LukeSky91/FlexRC/wykres_skalowania_joy.xlsx

Sheet: Joy_sim
SYMULATOR SKALOWANIA OSI JOYSTICKA (ESP32-S3, ADC 12-bit)
 | 1. PARAMETRY WEJŚCIOWE
 | Parametr | Wartość | Jednostka | Opis
 | Vfs | 3.10 | V | Pełna skala napięcia ADC
 | ADC_MAX | 4095 | - | Maksymalna wartość ADC (12-bit)
 | calMin | 300 | ADC | Dolna granica kalibracji
 | center | 2048 | ADC | Środek wychylenia
 | calMax | 3800 | ADC | Górna granica kalibracji
 | invert | NIE | - | Inwersja kierunku ADC
 | deadzone | 100 | ADC | Martwa strefa wokół środka
 | expo (obecna krzywa) | 3.00 | - | Wykładnik krzywej OBECNEJ, zakres 0-3
 | k (nowe RC expo) | 0.80 | - | Współczynnik krzywej NOWEJ (RC expo), zakres 0-1
 | p (potęga NOWA) | 3.50 | - | Wykładnik członu nieliniowego krzywej NOWEJ (RC expo), zalecane 3-9 (3 = oryginalny sześcian)
 | limit % | 100 | % | Limit wychylenia, zakres 0-100
 | 2. ALGORYTM – WARTOŚCI PO ZABEZPIECZENIACH FIRMWARE |  |  |  | Pomocnicze do wykresu (V)
 | calMin_eff | 300 | ADC | Jeśli calMax<=calMin+2 → calMin=0 | V(center) | 1.55037851
 | calMax_eff | 3800 | ADC | Jeśli calMax<=calMin+2 → calMax=ADC_MAX | V(center-deadzone) | 1.474676435
 | center_eff | 2048 | ADC | Jeśli center poza [calMin_eff;calMax_eff] → środek przedziału | V(center+deadzone) | 1.626080586
 | spanPos | 1752 | ADC | Zakres dodatni
 | spanNeg | 1748 | ADC | Zakres ujemny
 | ADC dla raw=calMin_eff (uwzgl. invert) | 300 | ADC
 | ADC dla raw=calMax_eff (uwzgl. invert) | 3800 | ADC
 | V dla calMin_eff (granica wykresu) | 0.2271062271 | V
 | V dla calMax_eff (granica wykresu) | 2.876678877 | V
 | 3. PRZELICZENIE "NA TERAZ"
 | V_now | 2.70 | V
 | Krok | OBECNA (powf) | NOWA (RC expo)
 | ADC | 3567 | 3567
 | raw | 3567 | 3567
 | center (eff.) | 2048 | 2048
 | c = raw - center | 1519 | 1519
 | sign | 1 | 1
 | absC | 1519 | 1519
 | xMax | 1752 | 1752
 | czy w deadzone? | NIE | NIE
 | norm | 0.8589588378 | 0.8589588378
 | % wychylenia (liniowo) | 85.89588378 | 85.89588378
 | curved (przed limitem) | 54.43640166 | 64.16785412
 | curved po limicie | 54.43640166 | 64.16785412
 | out | 54.43640166 | 64.16785412
 | tx (int8) | 54 | 64
 | WYNIK (tx wysyłany radiem)
 | tx OBECNA | 54
 | tx NOWA | 64
 | 4. TABELA POMOCNICZA DO WYKRESU (201 pkt) |  |  |  |  |  |  |  |  |  |  |  |  |  |  |  | Dane pomocnicze do wykresu (nie edytować)
 | V [V] | ADC | raw | c | absC | xMax | deadzone? | norm | % wychylenia (liniowo) | curved OBECNA (po limicie) | curved NOWA (po limicie) | out OBECNA | out NOWA | tx OBECNA | tx NOWA |  | V [V] | Liniowo | Obecna (powf) | Nowa (RC expo) | V_now | tx_now | V(center) | y | V(dz-) | y | V(dz+) | y
 | 0.240 | 318 | 318 | -1730 | 1730 | 1748 | NIE | 0.989 | -98.9 | 95.70 | 96.76 | -95.70 | -96.76 | -96 | -97 |  | 0.2403540904 | -98.90776699 | -96 | -97 | 2.7 | 54 | 1.55037851 | -100 | 1.474676435 | -100 | 1.626080586 | -100
 | 0.254 | 335 | 335 | -1713 | 1713 | 1748 | NIE | 0.979 | -97.9 | 91.77 | 93.78 | -91.77 | -93.78 | -92 | -94 |  | 0.2536019536 | -97.87621359 | -92 | -94 | 2.7 | 64 | 1.55037851 | 100 | 1.474676435 | 100 | 1.626080586 | 100
 | 0.267 | 353 | 353 | -1695 | 1695 | 1748 | NIE | 0.968 | -96.8 | 87.74 | 90.71 | -87.74 | -90.71 | -88 | -91 |  | 0.2668498168 | -96.78398058 | -88 | -91
 | 0.280 | 370 | 370 | -1678 | 1678 | 1748 | NIE | 0.958 | -95.8 | 84.06 | 87.88 | -84.06 | -87.88 | -84 | -88 |  | 0.2800976801 | -95.75242718 | -84 | -88
 | 0.293 | 388 | 388 | -1660 | 1660 | 1748 | NIE | 0.947 | -94.7 | 80.29 | 84.95 | -80.29 | -84.95 | -80 | -85 |  | 0.2933455433 | -94.66019417 | -80 | -85
 | 0.307 | 405 | 405 | -1643 | 1643 | 1748 | NIE | 0.936 | -93.6 | 76.85 | 82.26 | -76.85 | -82.26 | -77 | -82 |  | 0.3065934066 | -93.62864078 | -77 | -82
 | 0.320 | 423 | 423 | -1625 | 1625 | 1748 | NIE | 0.925 | -92.5 | 73.32 | 79.49 | -73.32 | -79.49 | -73 | -79 |  | 0.3198412698 | -92.53640777 | -73 | -79
 | 0.333 | 440 | 440 | -1608 | 1608 | 1748 | NIE | 0.915 | -91.5 | 70.11 | 76.93 | -70.11 | -76.93 | -70 | -77 |  | 0.3330891331 | -91.50485437 | -70 | -77
 | 0.346 | 458 | 458 | -1590 | 1590 | 1748 | NIE | 0.904 | -90.4 | 66.82 | 74.30 | -66.82 | -74.30 | -67 | -74 |  | 0.3463369963 | -90.41262136 | -67 | -74
 | 0.360 | 475 | 475 | -1573 | 1573 | 1748 | NIE | 0.894 | -89.4 | 63.82 | 71.88 | -63.82 | -71.88 | -64 | -72 |  | 0.3595848596 | -89.38106796 | -64 | -72
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
 | 2.863 | 3783 | 3783 | 1735 | 1735 | 1752 | NIE | 0.990 | 99.0 | 95.95 | 96.95 | 95.95 | 96.95 | 96 | 97 |  | 2.863431013 | 98.97094431 | 96 | 97
 | 2.877 | 3800 | 3800 | 1752 | 1752 | 1752 | NIE | 1.000 | 100.0 | 100.00 | 100.00 | 100.00 | 100.00 | 100 | 100 |  | 2.876678877 | 100 | 100 | 100
 | 2.890 | 3818 | 3818 | 1770 | 1770 | 1752 | NIE | 1.000 | 100.0 | 100.00 | 100.00 | 100.00 | 100.00 | 100 | 100 |  | 2.88992674 | 100 | 100 | 100
 | 6. TESTY (sprawdzenie dla parametrów domyślnych)
 | Opis testu | V_test [V] | ADC | raw | c | sign | absC | xMax | norm | curved OBECNA | curved NOWA | out OBECNA | out NOWA | tx OBECNA | tx NOWA | oczek. OBECNA | oczek. NOWA | OK? OBECNA | OK? NOWA
 | ADC = center_eff → tx=0 | 1.55037851 | 2048 | 2048 | 0 | 1 | 0 | 1752 | 0 | 0 | 0 | 0 | 0 | 0 | 0 | 0 | 0 | OK | OK
 | ADC = calMax_eff → tx=100 | 2.876678877 | 3800 | 3800 | 1752 | 1 | 1752 | 1752 | 1 | 100 | 100 | 100 | 100 | 100 | 100 | 100 | 100 | OK | OK
 | ADC = calMin_eff → tx=-100 | 0.2271062271 | 300 | 300 | -1748 | -1 | 1748 | 1748 | 1 | 100 | 100 | -100 | -100 | -100 | -100 | -100 | -100 | OK | OK
 | norm = 0.5 → OBECNA≈14, NOWA≈31 | 2.251379731 | 2974 | 2974 | 926 | 1 | 926 | 1752 | 0.5 | 6.25 | 17.07106781 | 6.25 | 17.07106781 | 6 | 17 | 14 | 31 | BŁĄD | BŁĄD

Sheet: MCU
component | analog sig | digital sig | comm |  | ARDUINO NANO
JOY L | 2 | 1 |  | SCK | D13 | D12 | MISO |  |  |  |  |  |  |  |  | ESP32-S3-Pico - Waveshare Wiki (https://www.waveshare.com/wiki/ESP32-S3-Pico)
JOY R | 2 | 1 |  |  | 3V3 | D11 | MOSI |  |  |  | ESP32-S3 WAVESHARE
5x KEY | 1 |  |  |  | AREF | D10 | CSN |  |  |  | 40 | VBUS | GP11 | 1 | SW_U1
2-3 FUN. KEYS |  | 2-3 |  | LX | A0 | D9 | CE |  |  | 5V IN | 39 | VSYS | GP12 | 2 | SW_L1
3-5x LED RGB |  | 1 |  | LY | A1 | D8 | LED RGB |  |  | GND | 38 | GND | GND | 3
OLED |  |  | I2C | RX | A2 | D7 | JOY R SW |  |  |  | 37 | 3V3_EN | GP13 | 4 | SW_C1
IMU |  |  | I2C | RY | A3 | D6 | JOY L SW |  |  |  | 36 | 3V3_OUT | GP14 | 5 | SW_R1
NRF24 PA LNA |  |  | SPI | SDA | A4 | D5 | BUZZ |  |  |  | 35 | ADC1_CH9 | GP15 | 6 | SW_D1
BATT LVL | 1 |  |  | SCL | A5 | D4 | SW2 |  |  |  | 34 | ADC1_CH8 | GP16 | 7
 |  |  |  | BATT | A6 | D3 | SW3-1 |  |  |  | 33 | GND | GND | 8
 |  |  |  | 5xKEY | A7 | D2 | SW3-2 |  |  | JOY R SW | 32 | ADC1_CH7 | GP17 | 9 | SDA
 |  |  |  |  | 5V | GND |  |  |  | JOY L SW | 31 | ADC1_CH6 | GP18 | 10 | SCL
 |  |  |  |  | RESET | RESET |  |  |  |  | 30 | RUN | GP33 | 11
 |  |  |  |  | GND | D0 |  |  |  | BATT | 29 | ADC1_CH5 | GP34 | 12 | SCK
 |  |  |  |  | VIN | D1 |  |  |  |  | 28 | GND | GND | 13
 |  |  |  |  |  |  |  | POT HALL |  | LX | 27 | ADC1_CH4 | GP35 | 14 | MISO
 |  |  |  |  |  |  |  | min | 0.47 | LY | 26 | ADC1_CH3 | GP36 | 15 | MOSI
 |  |  |  |  |  |  |  | mid | 1.305 | RX | 25 | ADC1_CH1 | GP37 | 16 | CSN
 |  |  |  |  |  |  |  | max | 2.2 | RY | 24 | ADC1_CH0 | GP38 | 17 | CE
 |  |  |  |  |  |  |  |  |  |  | 23 | GND | GND | 18
 |  |  |  |  |  |  |  | IMU i2c |  | SW_F1 | 22 | GP41 | GP39 | 19 | LED RGB
 |  |  |  |  |  |  |  |  |  | SW_F2 | 21 | GP42 | GP40 | 20
 |  |  |  |  |  |  |  |  |  |  |  | Waveshare |  | Sterownik WaveShare ESP32-S3-Pico • Cena, Opinie - Allegro (https://allegro.pl/produkt/sterownik-waveshare-esp32-s3-pico-0415ba11-c58a-4e15-a465-8a660298ffb0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)
 |  |  |  |  |  |  |  |  |  |  |  | 2x18650
 |  |  |  |  |  |  |  |  |  |  |  | BUCK 3.3V |  | AP63203 - przetwornica step-down BabyBuck - 3,3V 2A - SparkFun COM-18357 (https://botland.com.pl/przetwornice-step-down/20235-ap63203-przetwornica-step-down-babybuck-33v-2a-sparkfun-com-18357-5904422352097.html)
 |  |  |  |  |  |  |  |  |  |  |  | ~~buzzer~~
 |  |  |  |  |  |  |  |  |  |  |  | SW2 | ??
 |  |  |  |  |  |  |  |  |  |  |  | SW3 | ??
 |  |  |  |  |  |  |  |  |  |  |  | przełącznik ON-OFF |  | Przełącznik suwakowy ESP2010 - kątowy (https://botland.com.pl/przelaczniki-spdt/256-przelacznik-suwakowy-esp2010-katowy-5904422372781.html)
 |  |  |  |  |  |  |  |  |  |  |  |  |  | Potencjometr montażowy leżący 10kΩ - 5szt. (https://botland.com.pl/potencjometry-obrotowe-suwakowe-i-liniowe/307-potencjometr-montazowy-lezacy-10k-5szt-5904422372804.html)
 |  |  |  |  |  |  |  |  |  |  |  |  |  | Przełącznik monostabilny PB07C 7x7mm - 5 szt. (https://botland.com.pl/przelaczniki-przyciskowe-i-elektryczne/14950-przelacznik-monostabilny-pb07c-7x7mm-5-szt-5904422304058.html)
 |  |  |  |  |  |  |  |  |  |  |  |  |  | Mikroprzełącznik bistabilny ON-ON 7x7mm 5szt. (https://botland.com.pl/przelaczniki-przyciskowe-i-elektryczne/1416-mikroprzelacznik-bistabilny-on-on-7x7mm-5szt-5904422300005.html)
 |  |  |  |  |  |  |  |  |  |  |  | bezpieczniki polimerowe
 |  |  |  |  |  |  |  |  |  |  |  | BMS |  | 2S Li-ion 18650 Lithium Battery Charger Protection Board 7.4V Overcurrent Overcharge Overdischarge Protection 4A 2 Series BMS - AliExpress 502 (https://pl.aliexpress.com/item/33017997012.html?sourceType=1)
 |  |  |  |  |  |  |  |  |  |  |  | CHARGER |  | Wielokomorowy konwerter doładowania USB 2S 3S typu C moduł zasilania płyta ochronna ładowarki LiPo-polimerowej litowo-jonowej - AliExpress 502 (https://pl.aliexpress.com/item/1005005976542467.html?sourceType=1)
 |  |  |  |  |  |  |  |  |  |  | TOP VIEW
 |  |  |  |  |  |  |  |  |  |  | ESP32-S3 WAVESHARE
 |  |  |  |  |  |  |  |  |  |  | 21 | GP42 | GP40 | 20
 |  |  |  |  |  |  |  |  |  |  | 22 | GP41 | GP39 | 19
 |  |  |  |  |  |  |  |  |  |  | 23 | GND | GND | 18
 |  |  |  |  |  |  |  |  |  |  | 24 | ADC1_CH0 | GP38 | 17
 |  |  |  |  |  |  |  |  |  |  | 25 | ADC1_CH1 | GP37 | 16
 |  |  |  |  |  |  |  |  |  |  | 26 | ADC1_CH3 | GP36 | 15
 |  |  |  |  |  |  |  |  |  |  | 27 | ADC1_CH4 | GP35 | 14
 |  |  |  |  |  |  |  |  |  |  | 28 | GND | GND | 13
 |  |  |  |  |  |  |  |  |  |  | 29 | ADC1_CH5 | GP34 | 12
 |  |  |  |  |  |  |  |  |  |  | 30 | RUN | GP33 | 11
 |  |  |  |  |  |  |  |  |  |  | 31 | ADC1_CH6 | GP18 | 10
 |  |  |  |  |  |  |  |  |  |  | 32 | ADC1_CH7 | GP17 | 9
 |  |  |  |  |  |  |  |  |  |  | 33 | GND | GND | 8
 |  |  |  |  |  |  |  |  |  |  | 34 | ADC1_CH8 | GP16 | 7
 |  |  |  |  |  |  |  |  |  |  | 35 | ADC1_CH9 | GP15 | 6
 |  |  |  |  |  |  |  |  |  |  | 36 | 3V3_OUT | GP14 | 5
 |  |  |  |  |  |  |  |  |  |  | 37 | 3V3_EN | GP13 | 4
 |  |  |  |  |  |  |  |  |  |  | 38 | GND | GND | 3
 |  |  |  |  |  |  |  |  |  |  | 39 | VSYS | GP12 | 2
 |  |  |  |  |  |  |  |  |  |  | 40 | VBUS | GP11 | 1

Sheet: batt
AinMax | 3.3 | V
VmaxBatt | 8.4 | V
VminBatt | 6 | V
Uain | V*(R2/(R1+R2)) |  | Vbatt
I | VbattMax/(R1+R2) |  |  | R1
 |  |  |  |  | R5 |  | AIN
R1 | 33000 | Ohm |  | R2
R2 | 10000 | Ohm |  | R3 |  | C
R3 | 9100 |  | GND | R4
R4 | 1000
R5 | 1000 | Ohm
C | 100 | nF
UainMax | 3.180 | V
UainMin | 2.271 | V
zakres | 0.908
I | 0.158 | mA

Sheet: photoR
voltage | 3.30
light R | 5000
dark R | 800000 |  | voltage
 |  |  |  | photoR
resistor | 10000 |  |  |  | AIN
 |  |  |  | resistor
light V | 1.1 |  | GND
dark V | 3.26
photoR | 800000 | 800
R | 10000 | 10
output | 3.26
