LukeSky91/FlexRC/PCB/FlexRC/FlexRC.step

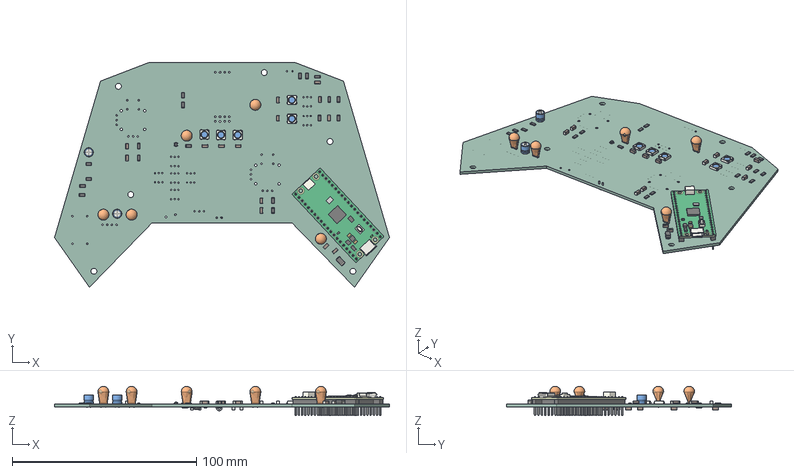
[picture p1: CAD file, 2026-11-08]
PCB/FlexRC/FlexRC.step
182.0 x 122.0 x 15.9 mm
R_1206_3216Metric x 31
LED_WS2812B_PLCC4_50x50mm_P32mm x 5
C_1206_3216Metric x 22
CP_Radial_Tantal_D60mm_P250mm x 5
C_Radial_D50mm_H50mm_P200mm x 2
SOT-353_SC-70-5
RaspberryPi_Pico_H_Module_KiCad
RaspberryPi_Pico_Header_DIP-40_H2.54mm_KiCad
D_SMA
SOT-23
TestPoint_Bridge_Pitch2.54mm_Drill1.0mm
Fle4091_PCB
