LukeSky91/FlexRC/PCB/FlexRC/PLOT/FlexRC.pdf

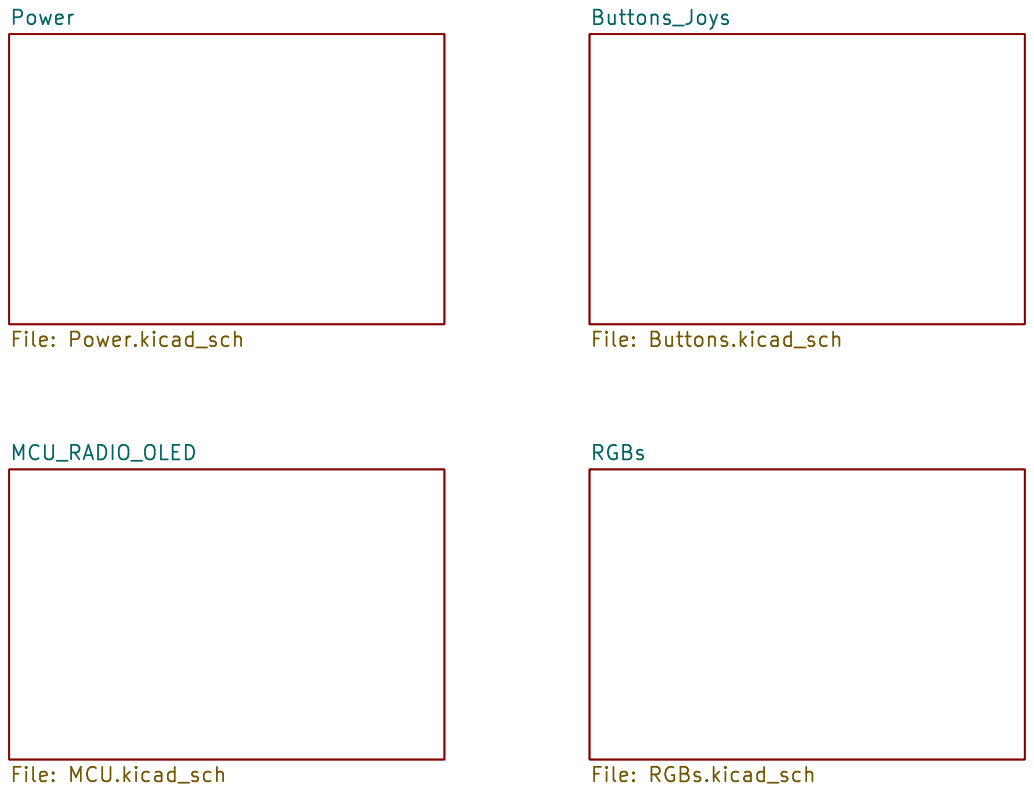
[picture p2: page 1]

https://github.com/LukeSky91/FlexRC
Luke

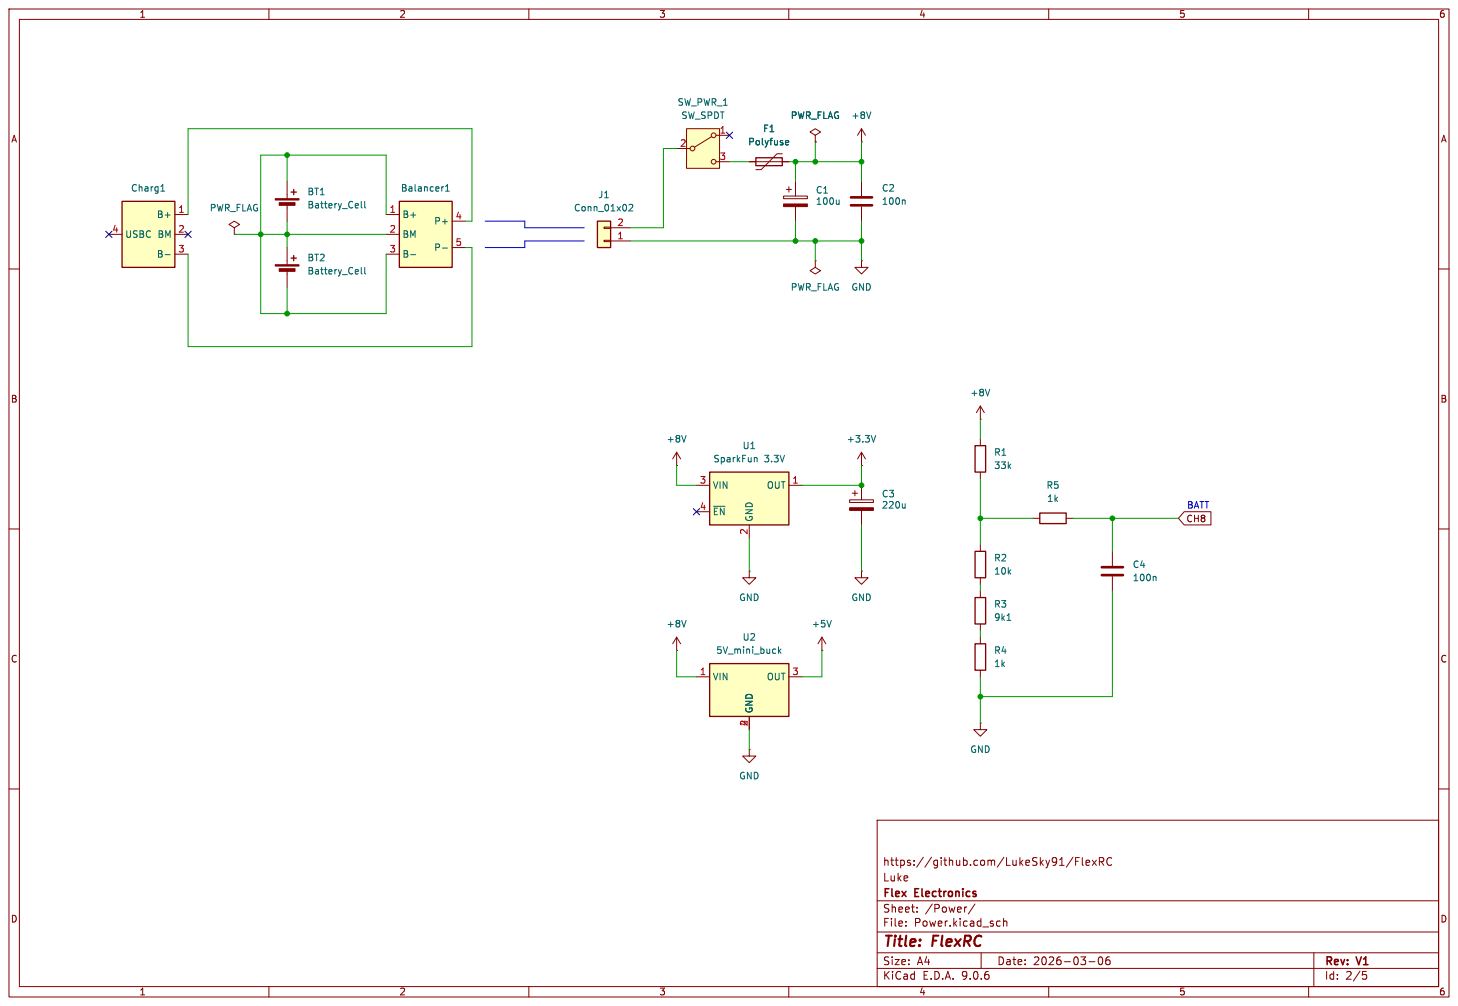
[picture p3: page 2]

https://github.com/LukeSky91/FlexRC
Luke

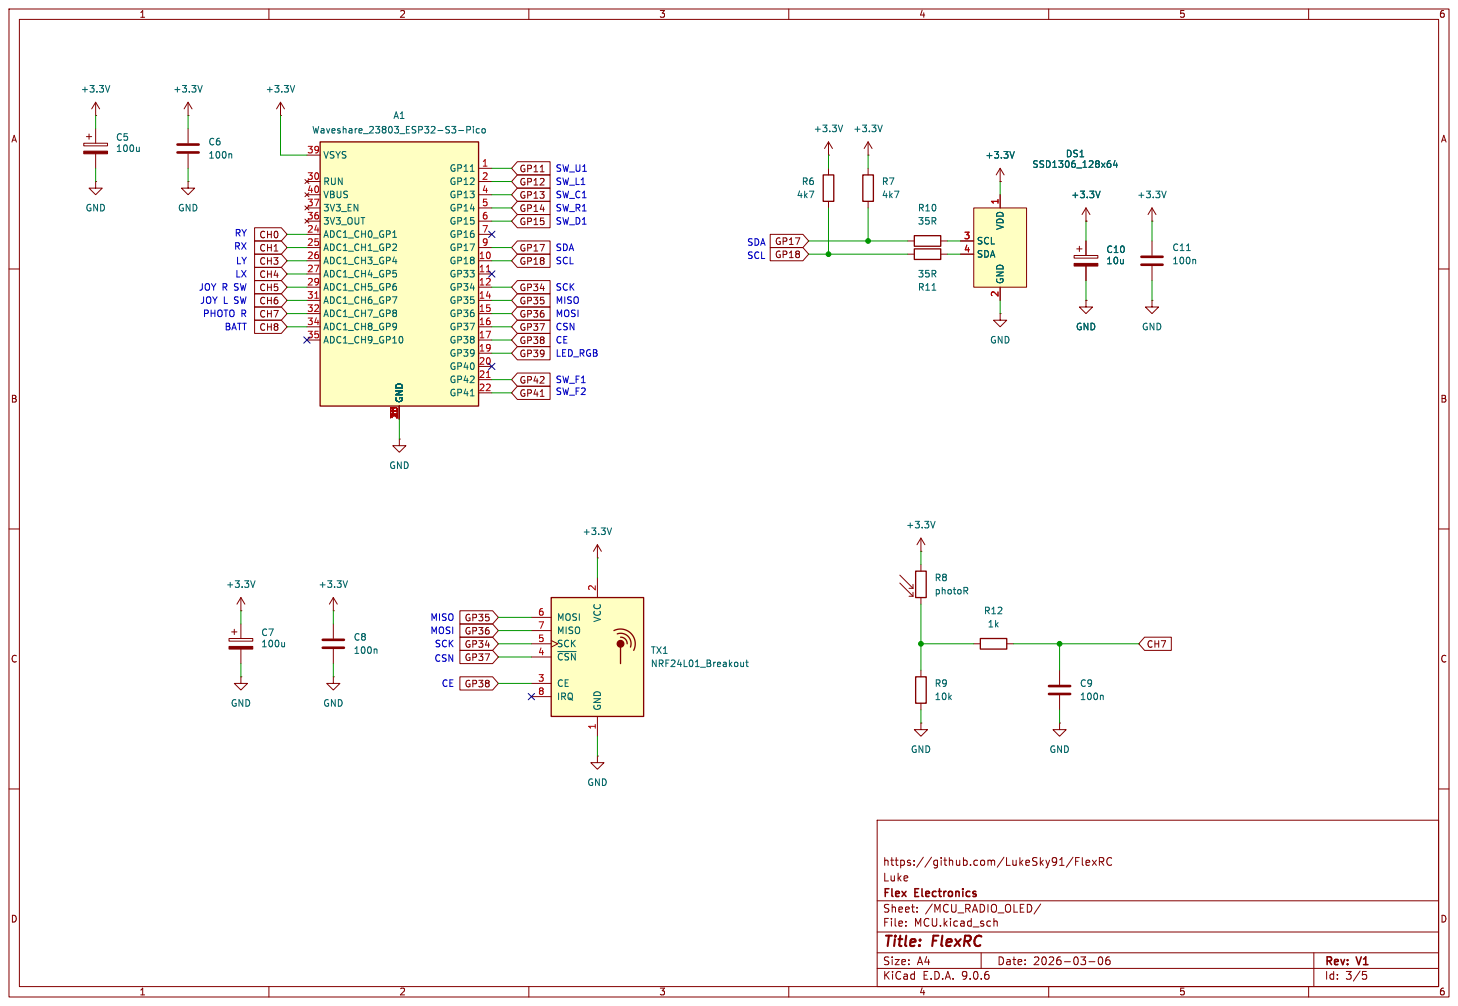
[picture p4: page 3]

JOY R SW
JOY L SW
LED_RGB CSN MOSI BATT PHOTO R

https://github.com/LukeSky91/FlexRC
Luke

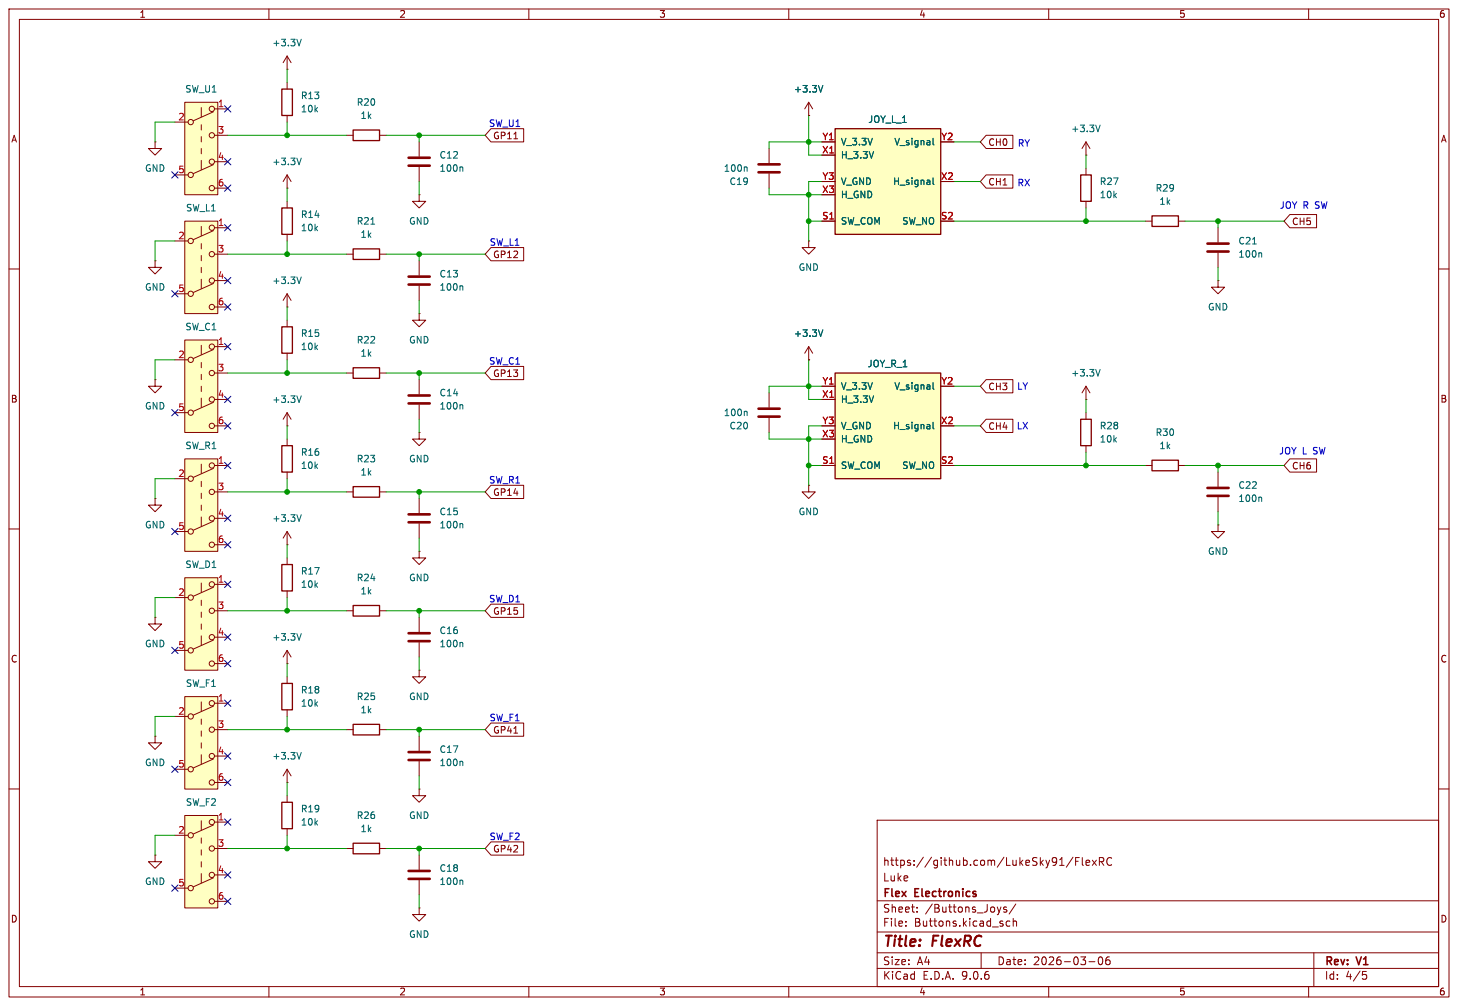
[picture p5: page 4]

https://github.com/LukeSky91/FlexRC
Luke

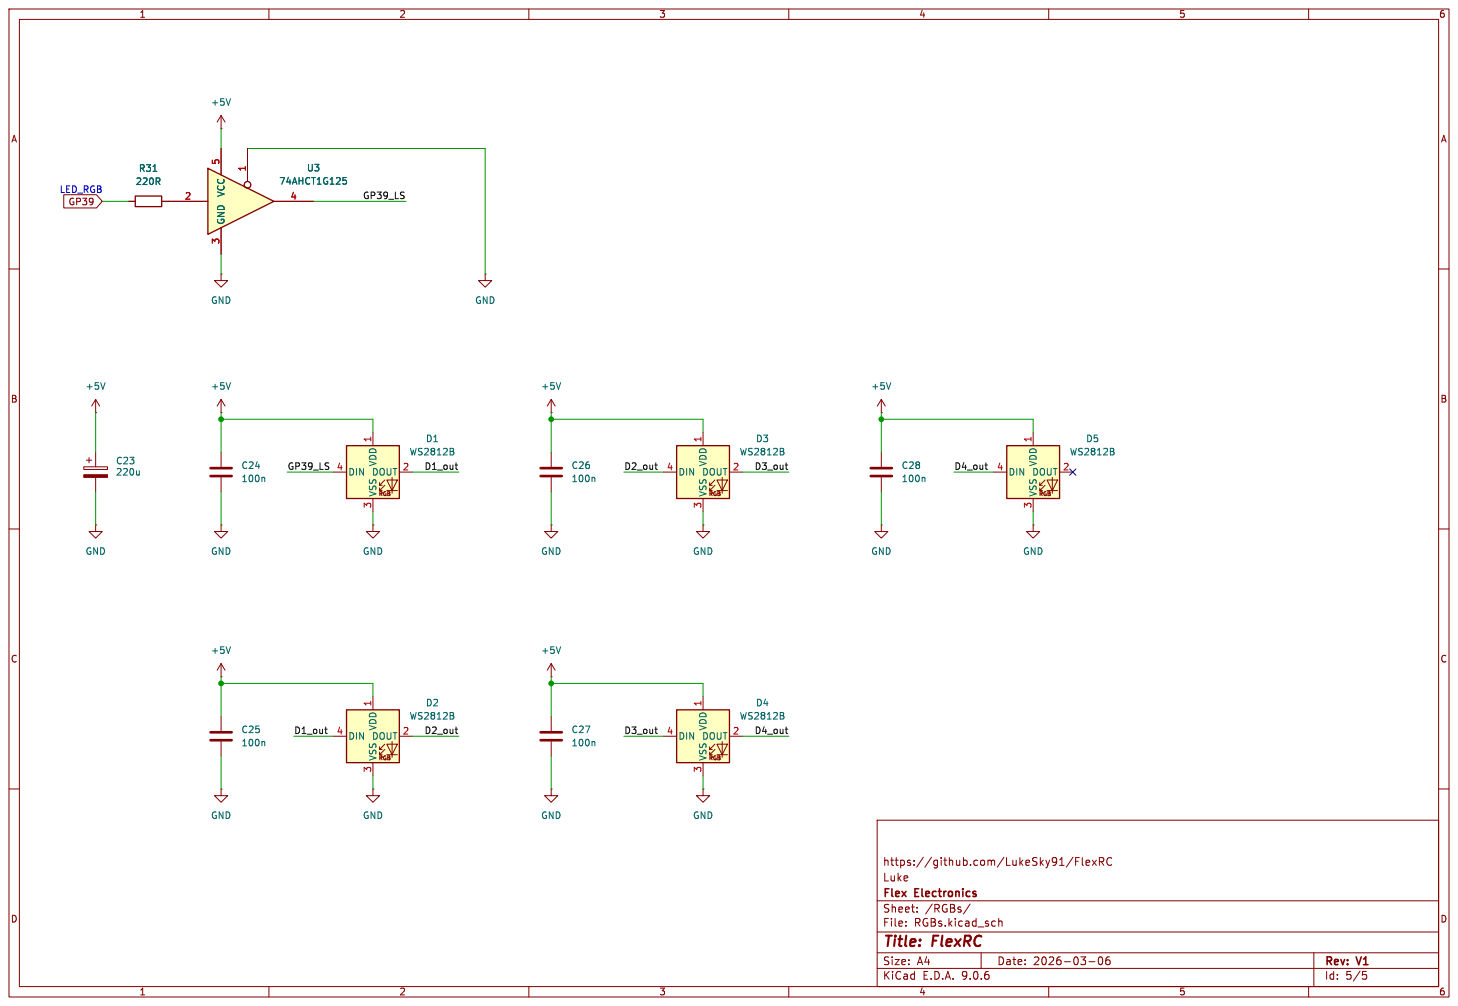
[picture p6: page 5]

https://github.com/LukeSky91/FlexRC
Luke
