LukeSky91/FlexRC/PCB/FlexRC_V2/PLOT/flexRC_board.pdf

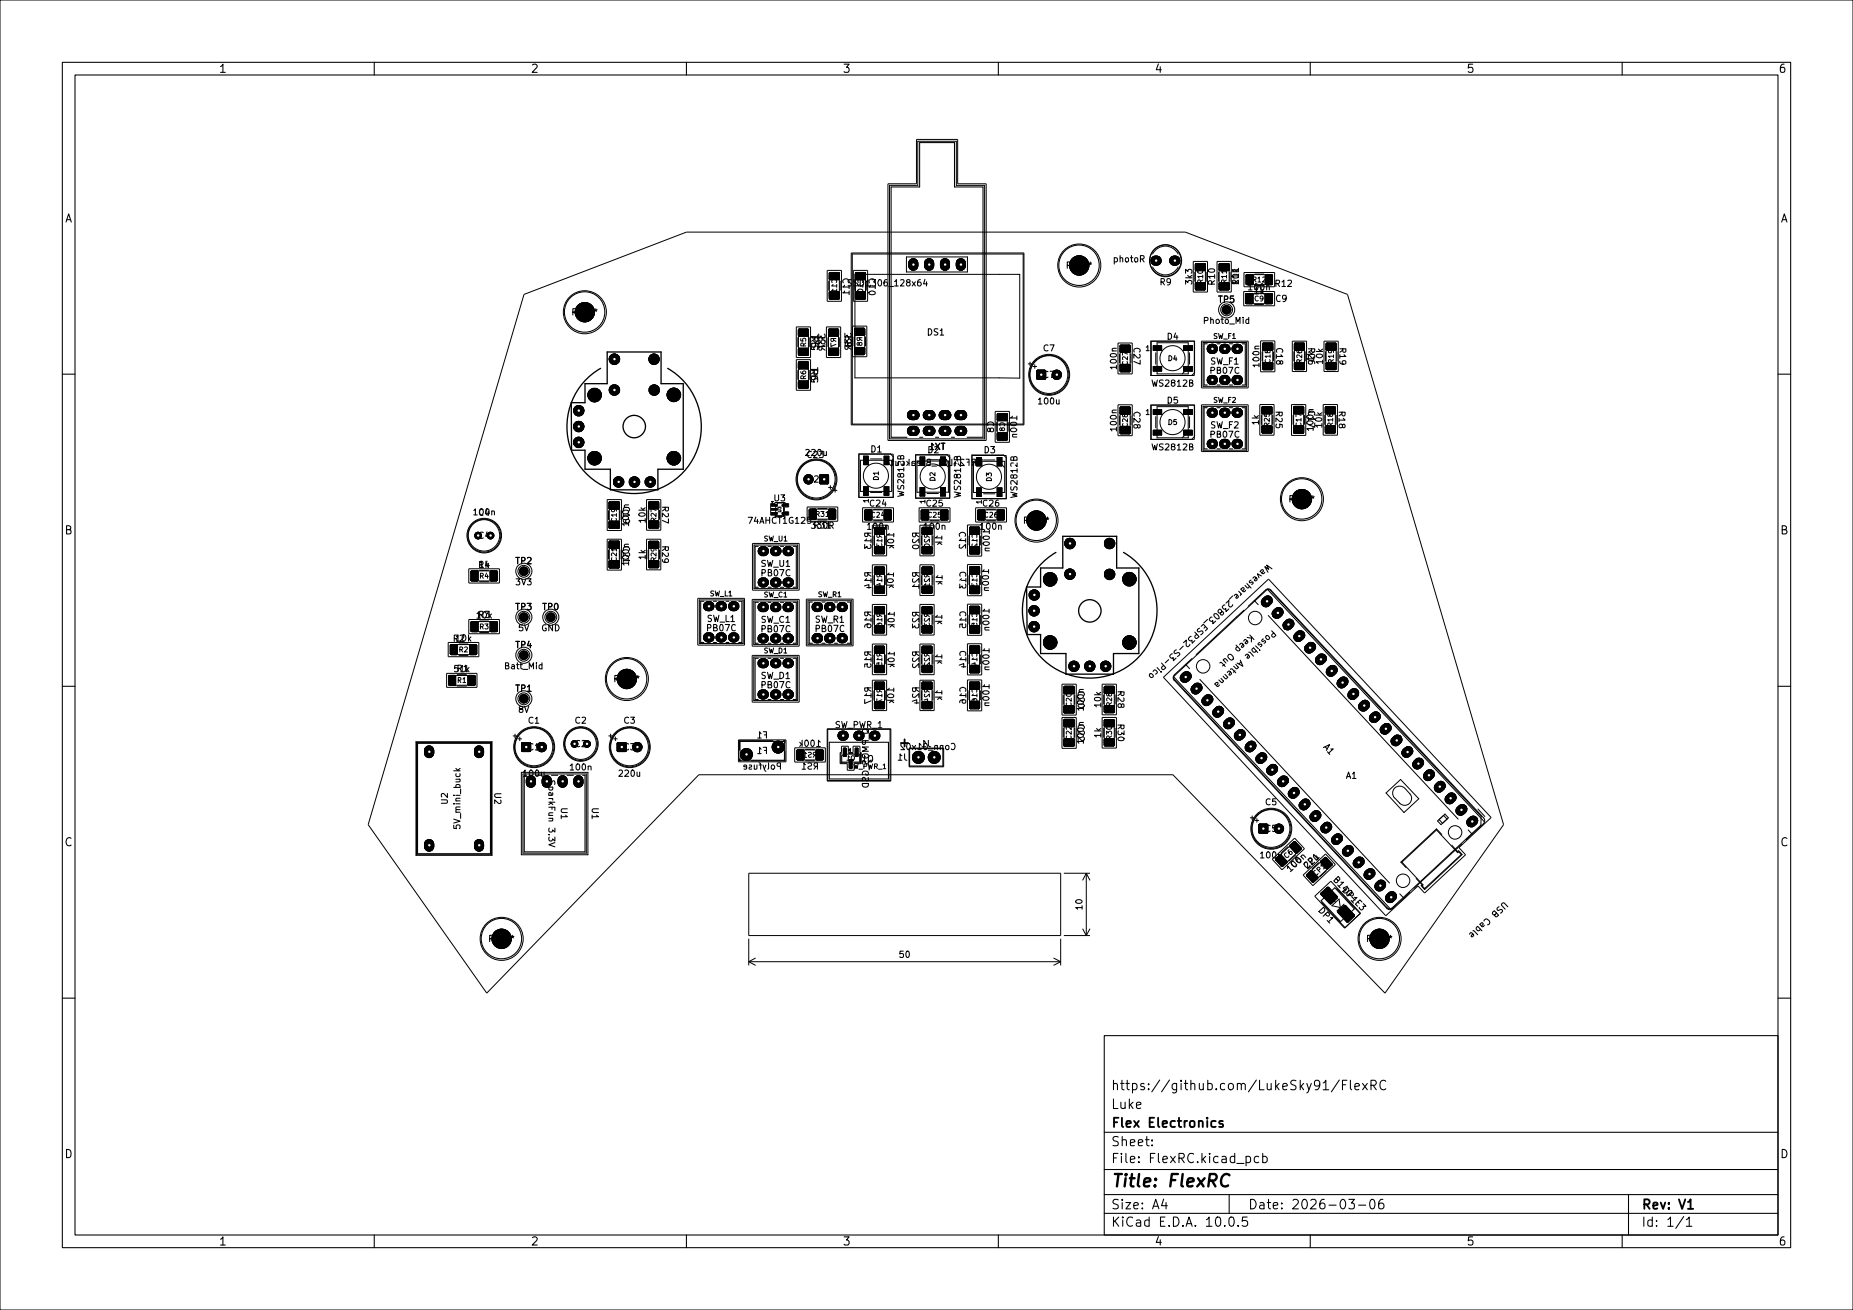
[picture p7: page 1]
