LukeSky91/FlexRC/PCB/FlexRC_V2/FlexRC.kicad_pcb

## KiCad design PCB/FlexRC_V2/FlexRC.kicad_pcb (2026-11-13)

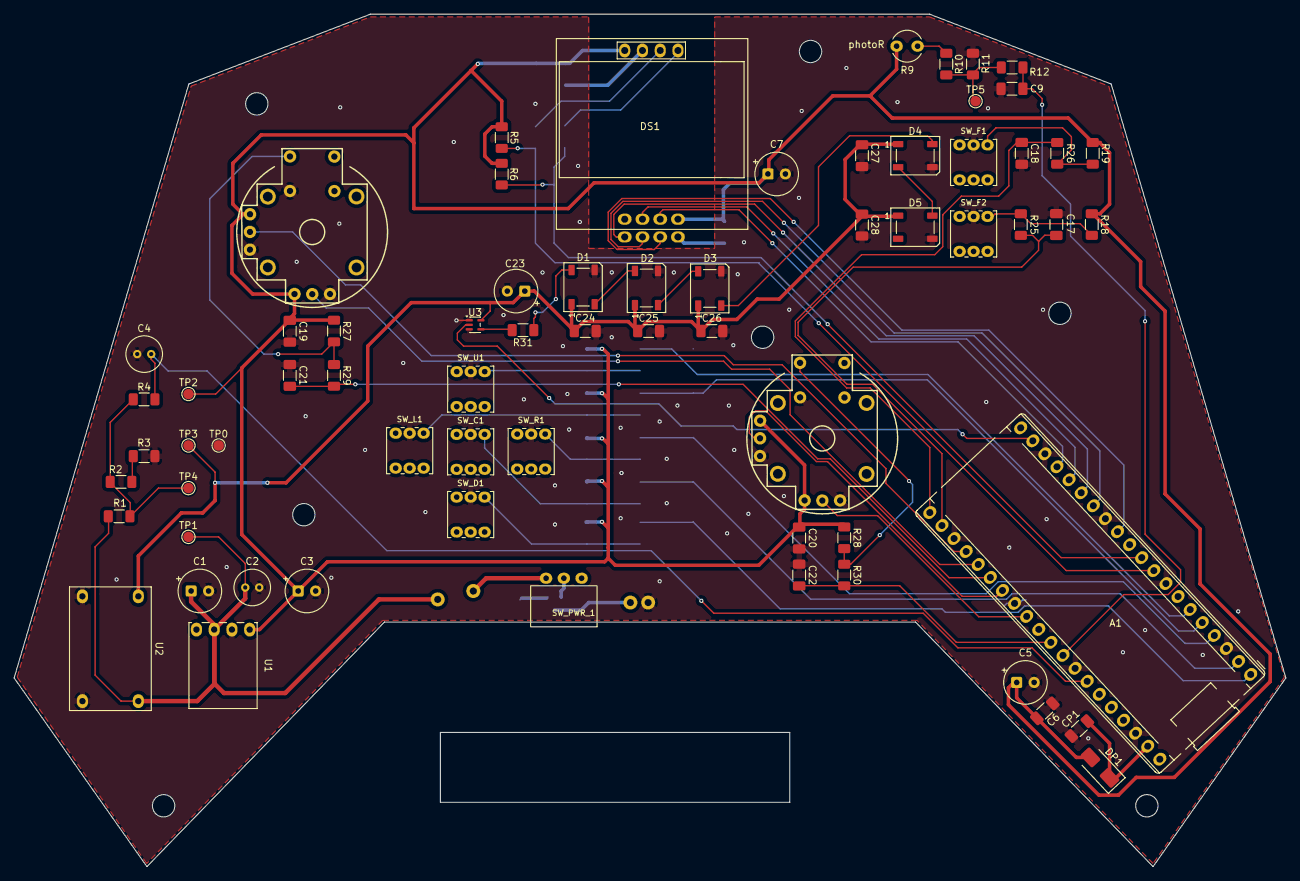
[picture p8: board FlexRC.kicad_pcb from above]

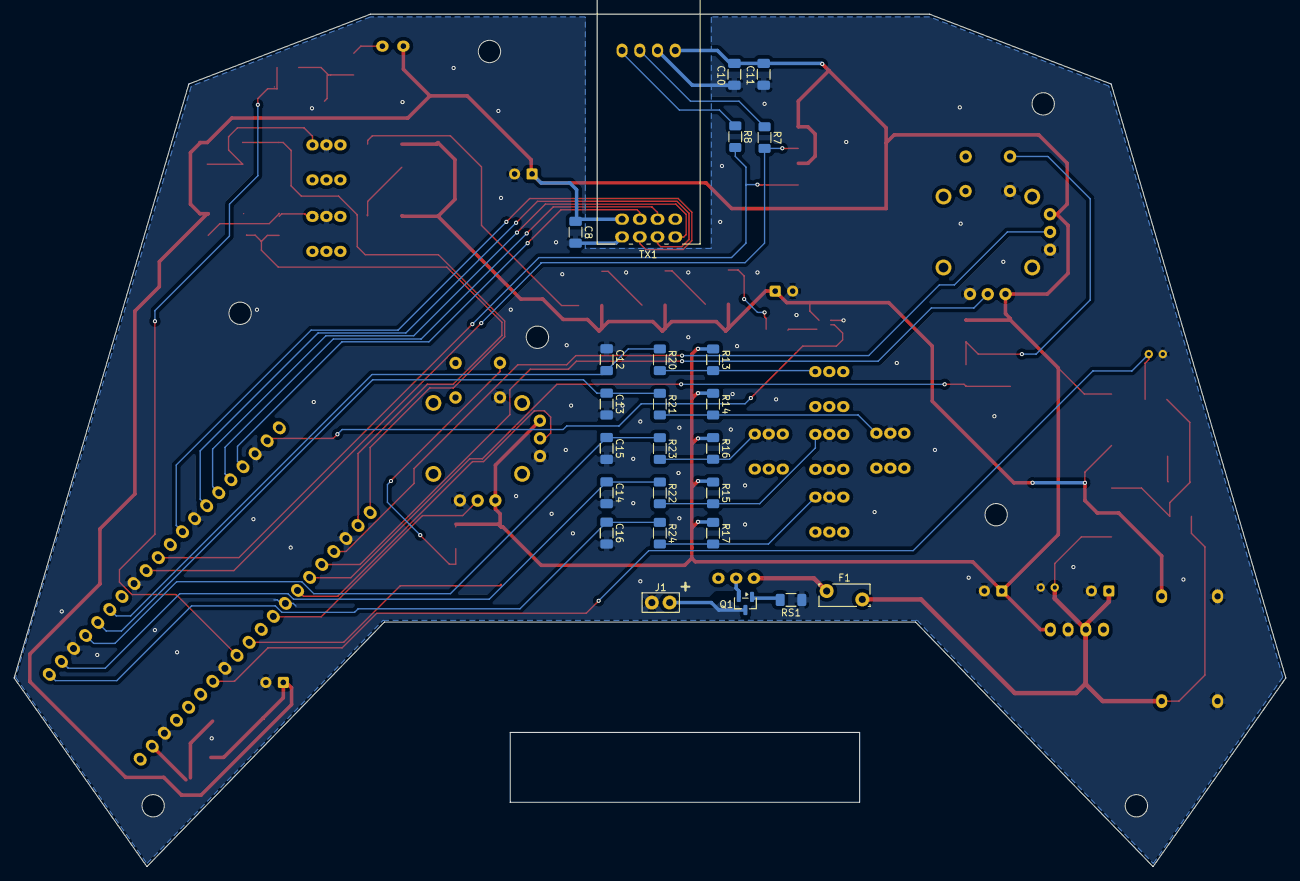
[picture p9: board FlexRC.kicad_pcb from below]

Board: 2 copper layers, 182.0 x 122.0 mm, 92 parts (25 on the bottom side), 53 nets.

Parts:
A1: Waveshare_23803_ESP32-S3-Pico
C1, C5, C7: 100u; CP_Radial_Tantal_D6.0mm_P2.50mm
C2, C4: 100n; C_Radial_D5.0mm_H5.0mm_P2.00mm
C3, C23: 220u; CP_Radial_Tantal_D6.0mm_P2.50mm
C6, C8, C9, C11, C12, C13, C14, C15, C16, C17, C18, C19, C20, C21, C22, C24, C25, C26, C27, C28: 100n; C_1206_3216Metric_Pad1.33x1.80mm_HandSolder
C10: 10n; C_1206_3216Metric_Pad1.33x1.80mm_HandSolder
CP1: 22u; C_1206_3216Metric_Pad1.33x1.80mm_HandSolder
D1, D2, D3, D4, D5: WS2812B; LED_WS2812B_PLCC4_5.0x5.0mm_P3.2mm
DP1: B140-E3; D_SMA
DS1: SSD1306_128x64; OLED_SSD1306_128x64_Module
F1: Polyfuse; Fuse_Bourns_MF-RG300
J1: Conn_01x02; 2pin_header_new
JOY_L_1: joystick-hall-effect; PS4_joystick
JOY_R_1: joystick-hall-effect; PS4_joystick
Q1: Q_PMOS_GSD; SOT-23
R1: 51k; R_1206_3216Metric_Pad1.30x1.75mm_HandSolder
R2, R3, R11, R13, R14, R15, R16, R17, R18, R19, R27, R28: 10k; R_1206_3216Metric_Pad1.30x1.75mm_HandSolder
R4, R12, R20, R21, R22, R23, R24, R25, R26, R29, R30: 1k; R_1206_3216Metric_Pad1.30x1.75mm_HandSolder
R5, R6: 5k1; R_1206_3216Metric_Pad1.30x1.75mm_HandSolder
R7, R8: 33R; R_1206_3216Metric_Pad1.30x1.75mm_HandSolder
R9: photoR; photoResistor
R10: 3k3; R_1206_3216Metric_Pad1.30x1.75mm_HandSolder
R31: 330R; R_1206_3216Metric_Pad1.30x1.75mm_HandSolder
RS1: 100k; R_1206_3216Metric_Pad1.30x1.75mm_HandSolder
SW_C1: PB07C; SW_PB07C_THT_6P
SW_D1: PB07C; SW_PB07C_THT_6P
SW_F1, SW_F2: PB07C; SW_PB07C_THT_6P
SW_L1: PB07C; SW_PB07C_THT_6P
SW_PWR_1: SW_SPDT; power_switch
SW_R1: PB07C; SW_PB07C_THT_6P
SW_U1: PB07C; SW_PB07C_THT_6P
TP0: GND; TestPoint_Pad_D1.5mm
TP1: 8V; TestPoint_Pad_D1.5mm
TP2: 3V3; TestPoint_Pad_D1.5mm
TP3: 5V; TestPoint_Pad_D1.5mm
TP4: Batt_Mid; TestPoint_Pad_D1.5mm
TP5: Photo_Mid; TestPoint_Pad_D1.5mm
TX1: NRF24L01_Breakout; nRF24L01_Breakout
U1: SparkFun 3.3V; AP63203 step-down BabyBuck - 3,3V 2A - SparkFun COM-18357
U2: 5V_mini_buck
U3: 74AHCT1G125; SOT-353_SC-70-5

Connections:
+3.3V: C3.1, C5.1, C6.1, C7.1, C8.1, C10.1, C11.1, C19.2, C20.2, DP1.2 (A), DS1.1 (VDD), JOY_L_1.X1 (H_3.3V), JOY_L_1.Y1 (V_3.3V), JOY_R_1.X1 (H_3.3V), JOY_R_1.Y1 (V_3.3V), R5.2, R6.2, R9.1, R13.1, R14.1, R15.1, R16.1, R17.1, R18.1, R19.1, R27.1, R28.1, TP2.1 (1_1), TX1.2 (VCC), U1.1 (OUT)
+5V: C23.1, C24.1, C25.1, C26.1, C27.1, C28.1, D1.1 (VDD), D2.1 (VDD), D3.1 (VDD), D4.1 (VDD), D5.1 (VDD), TP3.1 (1_1), U2.3 (OUT), U3.5 (VCC)
+8V: C1.1, C2.1, F1.2, R1.2, TP1.1 (1_1), U1.3 (VIN), U2.1 (VIN)
/RGBs/D1_out: D1.2 (DOUT), D2.4 (DIN)
/RGBs/D2_out: D2.2 (DOUT), D3.4 (DIN)
/RGBs/D3_out: D3.2 (DOUT), D4.4 (DIN)
/RGBs/D4_out: D4.2 (DOUT), D5.4 (DIN)
/RGBs/GP39_LS: D1.4 (DIN), R31.2
CH0: A1.24 (ADC1_CH0_GP1), JOY_L_1.Y2 (V_signal)
CH1: A1.25 (ADC1_CH1_GP2), JOY_L_1.X2 (H_signal)
CH3: A1.26 (ADC1_CH3_GP4), C21.1, R29.2
CH4: A1.27 (ADC1_CH4_GP5), JOY_R_1.Y2 (V_signal)
CH5: A1.29 (ADC1_CH5_GP6), JOY_R_1.X2 (H_signal)
CH6: A1.31 (ADC1_CH6_GP7), C22.1, R30.2
CH7: A1.32 (ADC1_CH7_GP8), C9.1, R12.2
CH8: A1.34 (ADC1_CH8_GP9), C4.1, R4.1
GND: A1.3 (GND), A1.8 (GND), A1.13 (GND), A1.18 (GND), A1.23 (GND), A1.28 (GND), A1.33 (GND), A1.38 (GND), C1.2, C2.2, C3.2, C4.2, C5.2, C6.2, C7.2, C8.2, C9.2, C10.2, C11.2, C12.2, C13.2, C14.2, C15.2, C16.2, C17.2, C18.2, C19.1, C20.1, C21.2, C22.2, C23.2, C24.2, C25.2, C26.2, C27.2, C28.2, CP1.2, D1.3 (VSS), D2.3 (VSS), D3.3 (VSS), D4.3 (VSS), D5.3 (VSS), DS1.2 (GND), J1.1, JOY_L_1.S1 (SW_COM), JOY_L_1.X3 (H_GND), JOY_L_1.Y3 (V_GND), JOY_R_1.S1 (SW_COM), JOY_R_1.X3 (H_GND), JOY_R_1.Y3 (V_GND), R3.1, R11.2, RS1.1, SW_C1.2 (B), SW_D1.2 (B), SW_F1.2 (B), SW_F2.2 (B), SW_L1.2 (B), SW_R1.2 (B), SW_U1.2 (B), TP0.1 (1_1), TX1.1 (GND), U1.2 (GND), U2.2 (GND), U2.4 (GND), U3.1, U3.3 (GND)
GP11: A1.1 (GP11), C16.1, R24.2
GP12: A1.2 (GP12), C14.1, R22.2
GP13: A1.4 (GP13), C15.1, R23.2
GP14: A1.5 (GP14), C13.1, R21.2
GP15: A1.6 (GP15), C12.1, R20.2
GP17: A1.9 (GP17), R5.1, R7.1
GP18: A1.10 (GP18), R6.1, R8.1
GP34: A1.12 (GP34), TX1.3 (CE)
GP35: A1.14 (GP35), TX1.5 (SCK)
GP36: A1.15 (GP36), TX1.7 (MISO)
GP37: A1.16 (GP37), TX1.6 (MOSI)
GP38: A1.17 (GP38), TX1.4 (~CSN)
GP39: A1.19 (GP39), U3.2
GP41: A1.22 (GP41), C17.1, R25.2
GP42: A1.21 (GP42), C18.1, R26.2
unnamed: A1.39 (VSYS), CP1.1, DP1.1 (K)
unnamed: DS1.3 (SCL), R7.2
unnamed: DS1.4 (SDA), R8.2
unnamed: J1.2, Q1.3 (D)
unnamed: JOY_L_1.S2 (SW_NO), R27.2, R29.1
unnamed: JOY_R_1.S2 (SW_NO), R28.2, R30.1
unnamed: Q1.1 (G), RS1.2
unnamed: Q1.2 (S), SW_PWR_1.2 (B)
unnamed: R1.1, R2.2, R4.2, TP4.1 (1_1)
unnamed: R2.1, R3.2
unnamed: R9.2, R10.1
unnamed: R10.2, R11.1, R12.1, TP5.1 (1_1)
unnamed: R13.2, R20.1, SW_U1.3 (C)
unnamed: R14.2, R21.1, SW_L1.3 (C)
unnamed: R15.2, R22.1, SW_C1.3 (C)
unnamed: R16.2, R23.1, SW_R1.3 (C)
unnamed: R17.2, R24.1, SW_D1.3 (C)
unnamed: R18.2, R25.1, SW_F2.3 (C)
unnamed: R19.2, R26.1, SW_F1.3 (C)
unnamed: R31.1, U3.4
unnamed: F1.1, SW_PWR_1.3 (C)
