LukeSky91/FlexRC/src/controller/buttons.cpp

#include <Arduino.h>
#include "controller/buttons.h"
#include "controller/config.h"

static const unsigned long debounceMs = 30;
static const bool BUTTONS_MONITOR = (PERF_DEBUG != 0);
static const uint8_t KEY_SLOT_COUNT = (uint8_t)Key::JR + 1;


static inline uint8_t idx(Key k) { return (uint8_t)k; }

struct Engine
{
    Key lastReading = Key::None;
    Key stable = Key::None;
    unsigned long lastChange = 0;
    unsigned long pressStart = 0;
    bool releasedPending[KEY_SLOT_COUNT] = {};
    uint32_t releaseDur[KEY_SLOT_COUNT] = {};
    bool shortPending[KEY_SLOT_COUNT] = {};
    bool longFired[KEY_SLOT_COUNT] = {};
    unsigned long lastRepeatAt[KEY_SLOT_COUNT] = {};
};

static Engine eng;
static Key lastReleaseKey = Key::None;

static inline bool isPhysicalPressed(uint8_t pin)
{
    return digitalRead(pin) == LOW;
}

static const char *keyName(Key k)
{
    switch (k)
    {
    case Key::Left:
        return "LEFT";
    case Key::Right:
        return "RIGHT";
    case Key::Up:
        return "UP";
    case Key::Down:
        return "DOWN";
    case Key::Center:
        return "CENTER";
    case Key::F1:
        return "F1";
    case Key::F2:
        return "F2";
    case Key::JL:
        return "LJ";
    case Key::JR:
        return "RJ";
    default:
        return "NONE";
    }
}

static void resetPerPressState(Key k)
{
    const uint8_t i = idx(k);
    if (i >= KEY_SLOT_COUNT)
        return;
    eng.longFired[i] = false;
    eng.lastRepeatAt[i] = 0;
}

static Key selectFirstPressed(Key preferred)
{
    switch (preferred)
    {
    case Key::Left:
        if (isPhysicalPressed(BUTTON_LEFT_PIN))
            return preferred;
        break;
    case Key::Right:
        if (isPhysicalPressed(BUTTON_RIGHT_PIN))
            return preferred;
        break;
    case Key::Up:
        if (isPhysicalPressed(BUTTON_UP_PIN))
            return preferred;
        break;
    case Key::Down:
        if (isPhysicalPressed(BUTTON_DOWN_PIN))
            return preferred;
        break;
    case Key::Center:
        if (isPhysicalPressed(BUTTON_CENTER_PIN))
            return preferred;
        break;
    case Key::F1:
        if (isPhysicalPressed(BUTTON_F1_PIN))
            return preferred;
        break;
    case Key::F2:
        if (isPhysicalPressed(BUTTON_F2_PIN))
            return preferred;
        break;
    case Key::JL:
        if (isPhysicalPressed(JOY_L_PIN_BTN))
            return preferred;
        break;
    case Key::JR:
        if (isPhysicalPressed(JOY_R_PIN_BTN))
            return preferred;
        break;
    default:
        break;
    }

    if (isPhysicalPressed(BUTTON_UP_PIN))
        return Key::Up;
    if (isPhysicalPressed(BUTTON_DOWN_PIN))
        return Key::Down;
    if (isPhysicalPressed(BUTTON_LEFT_PIN))
        return Key::Left;
    if (isPhysicalPressed(BUTTON_RIGHT_PIN))
        return Key::Right;
    if (isPhysicalPressed(BUTTON_CENTER_PIN))
        return Key::Center;
    if (isPhysicalPressed(BUTTON_F1_PIN))
        return Key::F1;
    if (isPhysicalPressed(BUTTON_F2_PIN))
        return Key::F2;
    if (isPhysicalPressed(JOY_L_PIN_BTN))
        return Key::JL;
    if (isPhysicalPressed(JOY_R_PIN_BTN))
        return Key::JR;
    return Key::None;
}

static void buttonsUpdate()
{
    const Key reading = selectFirstPressed(eng.stable);

    if (reading != eng.lastReading)
    {
        eng.lastChange = millis();
        eng.lastReading = reading;
    }

    if ((millis() - eng.lastChange) <= debounceMs)
        return;

    if (reading == eng.stable)
        return;

    const Key prev = eng.stable;
    eng.stable = reading;

    if (prev == Key::None && eng.stable != Key::None)
    {
        eng.pressStart = millis();
        resetPerPressState(eng.stable);

        if (BUTTONS_MONITOR)
        {
            Serial.print("[BTN] PRESSED  ");
            Serial.println(keyName(eng.stable));
        }
        return;
    }

    if (prev != Key::None)
    {
        const uint8_t ip = idx(prev);
        uint32_t dur = 0;
        if (eng.pressStart != 0)
            dur = (uint32_t)(millis() - eng.pressStart);

        if (ip < KEY_SLOT_COUNT)
        {
            eng.releaseDur[ip] = dur;
            eng.releasedPending[ip] = true;
            if (!eng.longFired[ip])
                eng.shortPending[ip] = true;
        }

        lastReleaseKey = prev;

        if (BUTTONS_MONITOR)
        {
            Serial.print("[BTN] RELEASED ");
            Serial.print(keyName(prev));
            Serial.print("  dur=");
            Serial.print(dur);
            Serial.println(" ms");
        }
    }

    if (eng.stable != Key::None)
    {
        eng.pressStart = millis();
        resetPerPressState(eng.stable);

        if (BUTTONS_MONITOR)
        {
            Serial.print("[BTN] PRESSED  ");
            Serial.println(keyName(eng.stable));
        }
    }
    else
    {
        eng.pressStart = 0;
    }
}

void buttonsInit()
{
    pinMode(BUTTON_UP_PIN, INPUT_PULLUP);
    pinMode(BUTTON_DOWN_PIN, INPUT_PULLUP);
    pinMode(BUTTON_LEFT_PIN, INPUT_PULLUP);
    pinMode(BUTTON_RIGHT_PIN, INPUT_PULLUP);
    pinMode(BUTTON_CENTER_PIN, INPUT_PULLUP);
    pinMode(BUTTON_F1_PIN, INPUT_PULLUP);
    pinMode(BUTTON_F2_PIN, INPUT_PULLUP);
    pinMode(JOY_L_PIN_BTN, INPUT_PULLUP);
    pinMode(JOY_R_PIN_BTN, INPUT_PULLUP);

    eng = Engine{};
}

bool keyDown(Key k)
{
    buttonsUpdate();
    return eng.stable == k;
}

bool keyReleased(Key k, uint32_t *durationMs, bool consume)
{
    buttonsUpdate();
    const uint8_t i = idx(k);
    if (i >= KEY_SLOT_COUNT)
        return false;

    if (!eng.releasedPending[i])
        return false;

    if (durationMs)
        *durationMs = eng.releaseDur[i];

    if (consume)
    {
        eng.releasedPending[i] = false;
        eng.shortPending[i] = false;
    }
    return true;
}

Key buttonsLastReleaseKey()
{
    return lastReleaseKey;
}

void buttonsConsumeAll()
{
    const Key current = eng.stable;
    eng = Engine{};
    eng.stable = current;
    eng.lastReading = current;
}

bool keyShortClick(Key k, uint32_t thresholdMs, bool consume)
{
    buttonsUpdate();
    const uint8_t i = idx(k);
    if (i >= KEY_SLOT_COUNT || !eng.shortPending[i])
        return false;

    const bool isShort = (eng.releaseDur[i] < thresholdMs);
    if (consume)
    {
        eng.shortPending[i] = false;
        eng.releasedPending[i] = false;
    }
    return isShort;
}

bool keyLongPress(Key k,
                  bool repeat,
                  uint32_t repeatMs,
                  uint32_t thresholdMs,
                  bool consume)
{
    buttonsUpdate();

    if (k == Key::None || eng.stable != k || eng.pressStart == 0)
        return false;

    const uint8_t i = idx(k);
    if (i >= KEY_SLOT_COUNT)
        return false;

    const uint32_t held = (uint32_t)(millis() - eng.pressStart);
    if (held < thresholdMs)
        return false;

    if (!eng.longFired[i])
    {
        if (consume)
            eng.longFired[i] = true;
        eng.lastRepeatAt[i] = millis();
        return true;
    }

    if (repeat)
    {
        const unsigned long now = millis();
        if (now - eng.lastRepeatAt[i] >= repeatMs)
        {
            eng.lastRepeatAt[i] = now;
            return true;
        }
    }

    return false;
}

void buttonsTick()
{
    buttonsUpdate();
}
