LukeSky91/FlexRC/include/receivers/test_platform/config.h

#pragma once
#include <stdint.h>

#define ROLE_RECEIVER 1

// NRF24L01 pin mapping (Arduino Mega 2560)
#define NRF24_CSN_PIN 8
#define NRF24_CE_PIN 7
#define NRF24_SCK_PIN 52
#define NRF24_MOSI_PIN 51
#define NRF24_MISO_PIN 50
#define NRF_CHANNEL 76
#define NRF_PA_LEVEL 0 // RF24_PA_MIN (range: 0=MIN .. 3=MAX)
static const uint8_t NRF_ADDR[5] = {'R', 'C', '0', '0', '1'};
#define NRF_ENABLED 1

#define BATTERY_PIN A1
#define BATTERY_READ_INTERVAL_MS 200
#define BATTERY_AVG_SAMPLES 8
#define BATTERY_ADC_REF_MV 5000UL
#define BATTERY_DIVIDER_R_TOP_OHM 100000UL
#define BATTERY_DIVIDER_R_BOTTOM_OHM 100000UL
#define BATTERY_CELL_EMPTY_MV 3300U
#define BATTERY_CELL_FULL_MV 4200U

#define STEERING_PWM_PIN 9
#define THROTTLE_PWM_PIN 10

#define SERIAL_ENABLED 1
#define SERIAL_BAUD 115200
