LukeSky91/FlexRC/(commit log)

2026-01-11 Initial commit – FlexRC_v1
    [wykres_skalowania_joy.xlsx]
2026-11-08 FlexRC_esp32_v6: PCB rev V1, CLAUDE.md, odbiornik testowy
    - schemat/PCB: aktualizacja arkuszy i footprintow, eksport STEP i PDF plytki
    - usuniete stare gerbery z PCB/FlexRC/PLOT
    - CLAUDE.md z opisem projektu i lista TODO
    - odbiornik testowy: zmiany w config.h i main.cpp, platformio.ini
    - .gitignore: autosave KiCada i .history VSCode
2026-11-08 Schemat MCU: poprawione etykiety tekstowe SDA/SCL
    Etykiety tekstowe przy liniach I2C byly zamienione. Teraz SCL=GP17,
    SDA=GP18, zgodnie z firmware. Netlista bez zmian (FAZA 1B).
2026-11-08 Firmware nadajnika: mapa pinów wg PCB rev V1
    - hardware_config.h: piny wg netlisty FlexRC.kicad_pcb (gimbale L/R,
    przyciski gimbali, D-pad, SPI nRF24 CE/SCK/MISO/MOSI/CSN = 34..38);
    komentarze z oznaczeniami elementów PCB. Stykówka nie jest już wspierana
    (ostatni stan: tag breadboard-working).
    - config.h: dzielnik baterii R1 51k / R2+R3 20k.
    - io_readings.cpp: etykiety GPIO/ADC zgodne z nową mapą.
    - CLAUDE.md: jedna tabela pinów wg PCB, FAZA 3 przemapowanie zrobione,
    FAZA 1 R1 = 51k.
2026-11-08 PCB: Q1 (P-MOSFET zabezpieczenia polaryzacji) odwrócony
    Drain do J1 (bateria +), source do SW_PWR_1, bramka przez RS1 do GND.
    Poprzednio S/D były zamienione i zabezpieczenie nie działało.
2026-11-08 CLAUDE.md: aktualizacja do stanu faktycznego PCB rev V1 i firmware
    - zasilanie wg netlisty: DP1 B140 na VSYS, CP1 22u, Q1, F1 MF-RG300
    - FAZA 1: odhaczone punkty naniesione na PCB, nowe otwarte punkty
    (wybór Q1, J1, etykiety Radio.kicad_sch, C7/C8, SSD1306 vs SH1106)
    - firmware: piny wg PCB, blokujący flush OLED, timing TX, failsafe odbiornika
    - KiCad 10.0, STEP wyeksportowany
2026-11-13 pcb v2
2026-11-13 CLAUDE.md: OLED SPI, krzywa joy (k,p), założenia i stan schematu V2, enkoder PEC11R
    Claude-Session: https://claude.ai/code/session_012PRUMmk5f3njitUeYmwLM3
